paulvee/Lars-GPSDO-V4.2/IMG_3340.JPG

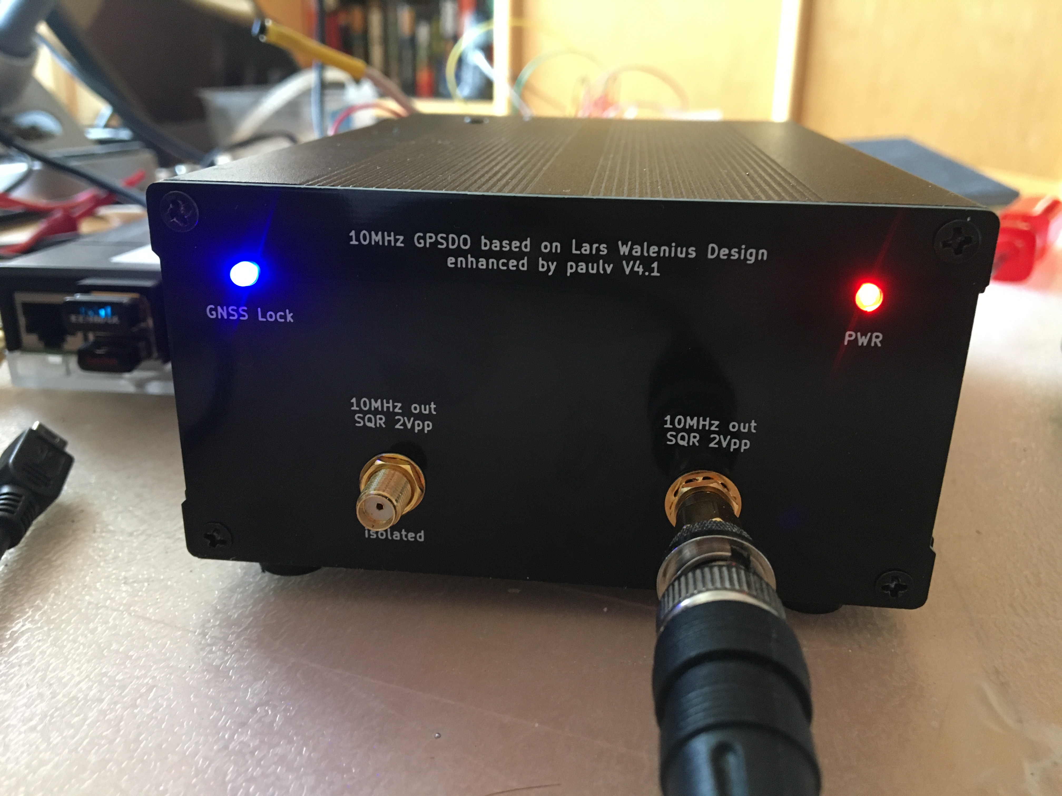
IMG_3340.JPG
