paulvee/Lars-GPSDO-V4.2/IMG_3341.JPG

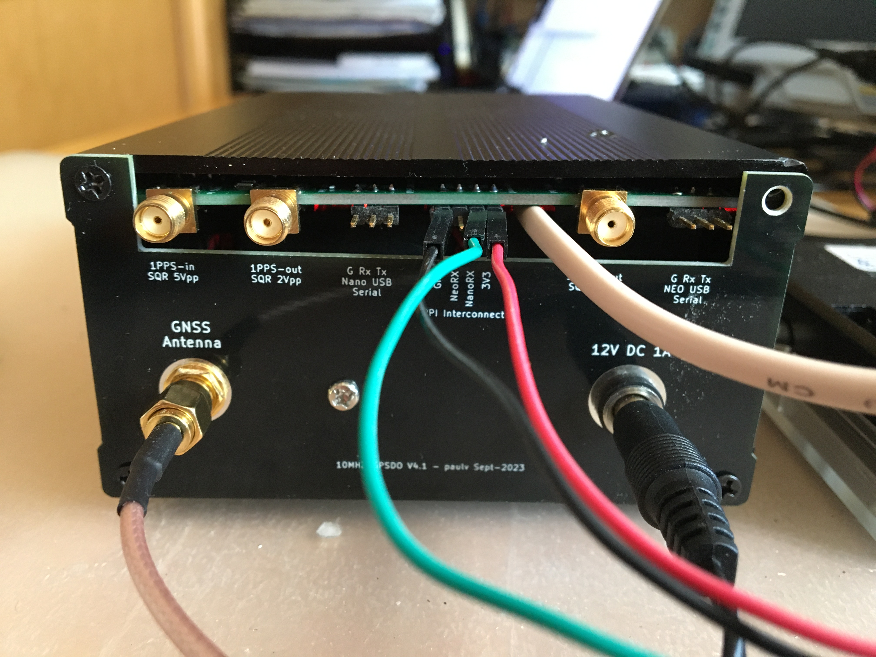
IMG_3341.JPG
