paulvee/Lars-GPSDO-V4.2/BackPlate.png

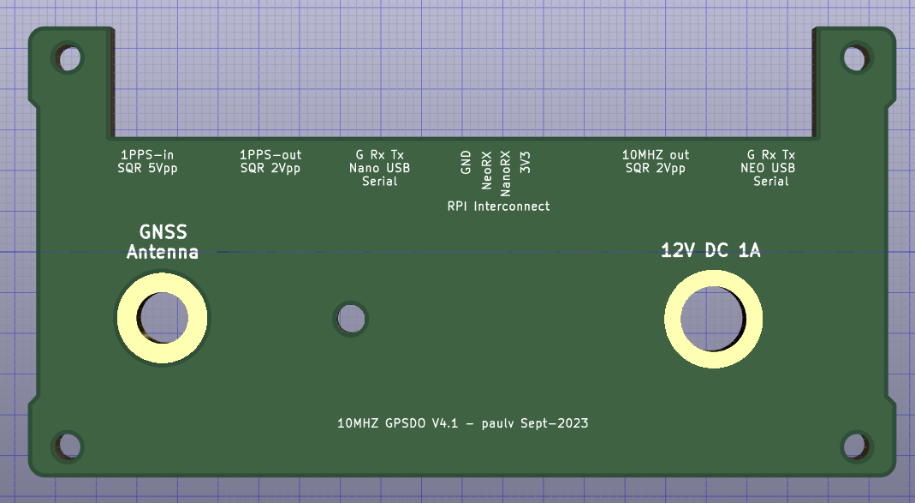
BackPlate.png
