paulvee/Lars-GPSDO-V4.2/Controller.png

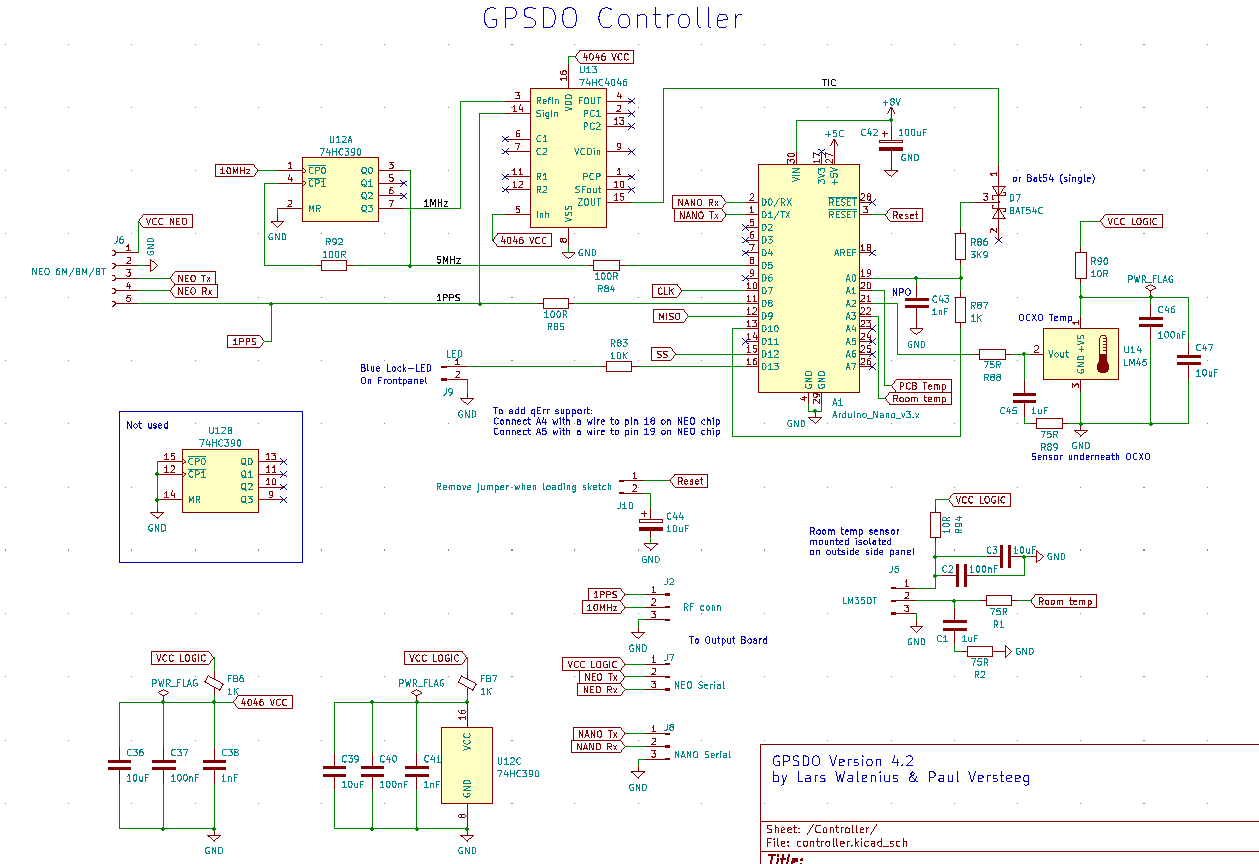
Controller.png
