paulvee/Lars-GPSDO-V4.2/DAC.png

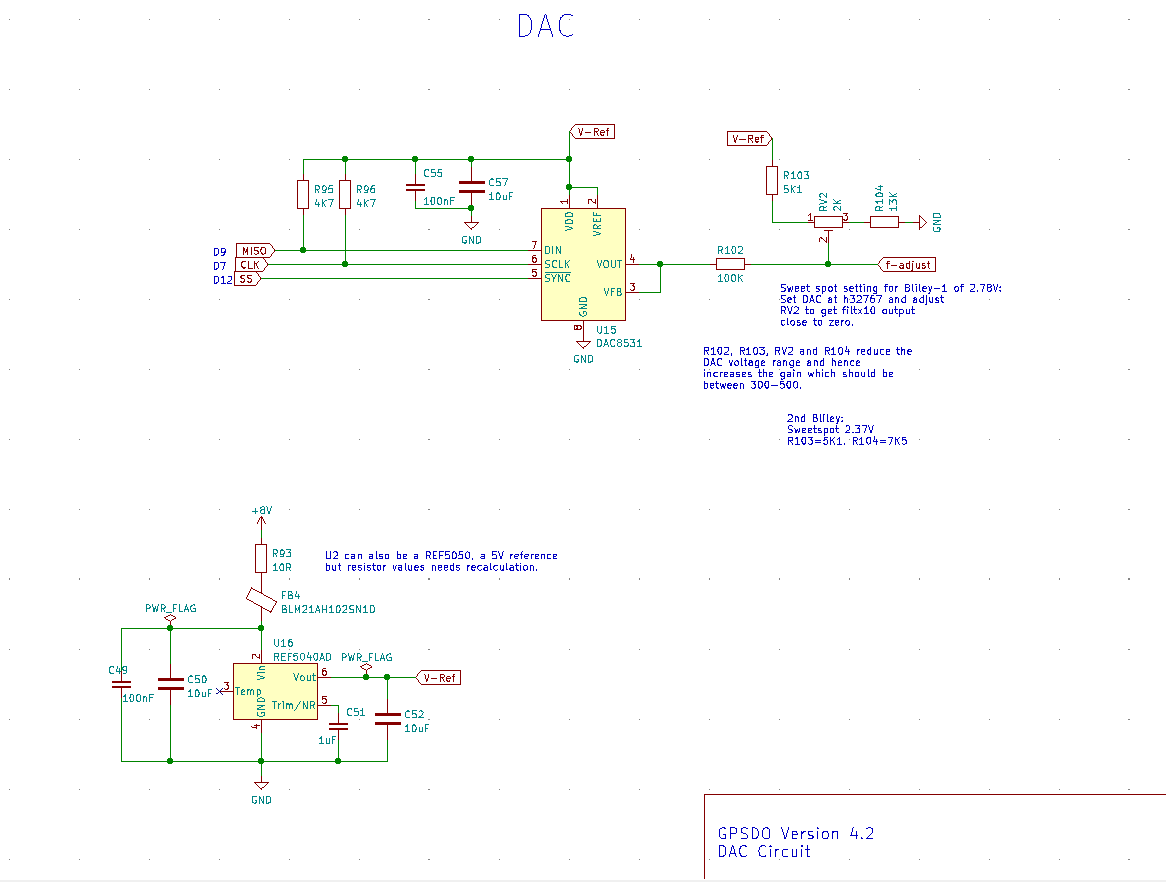
DAC.png
