paulvee/Lars-GPSDO-V4.2/FacePlate GPSDO.png

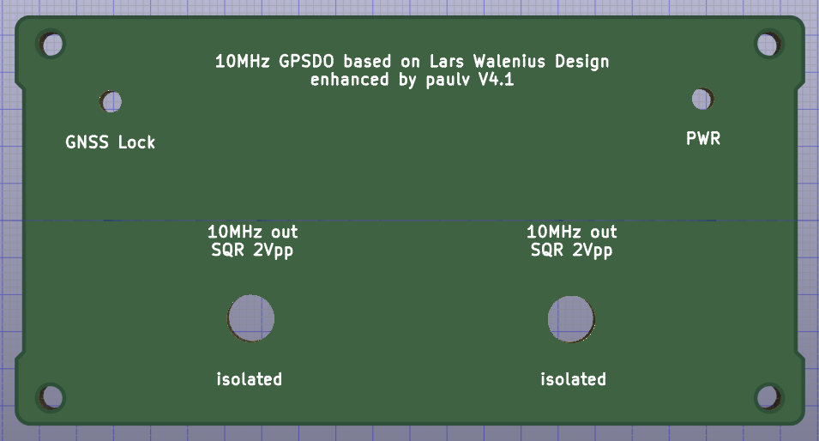
FacePlate GPSDO.png
