paulvee/Lars-GPSDO-V4.2/Heater.png

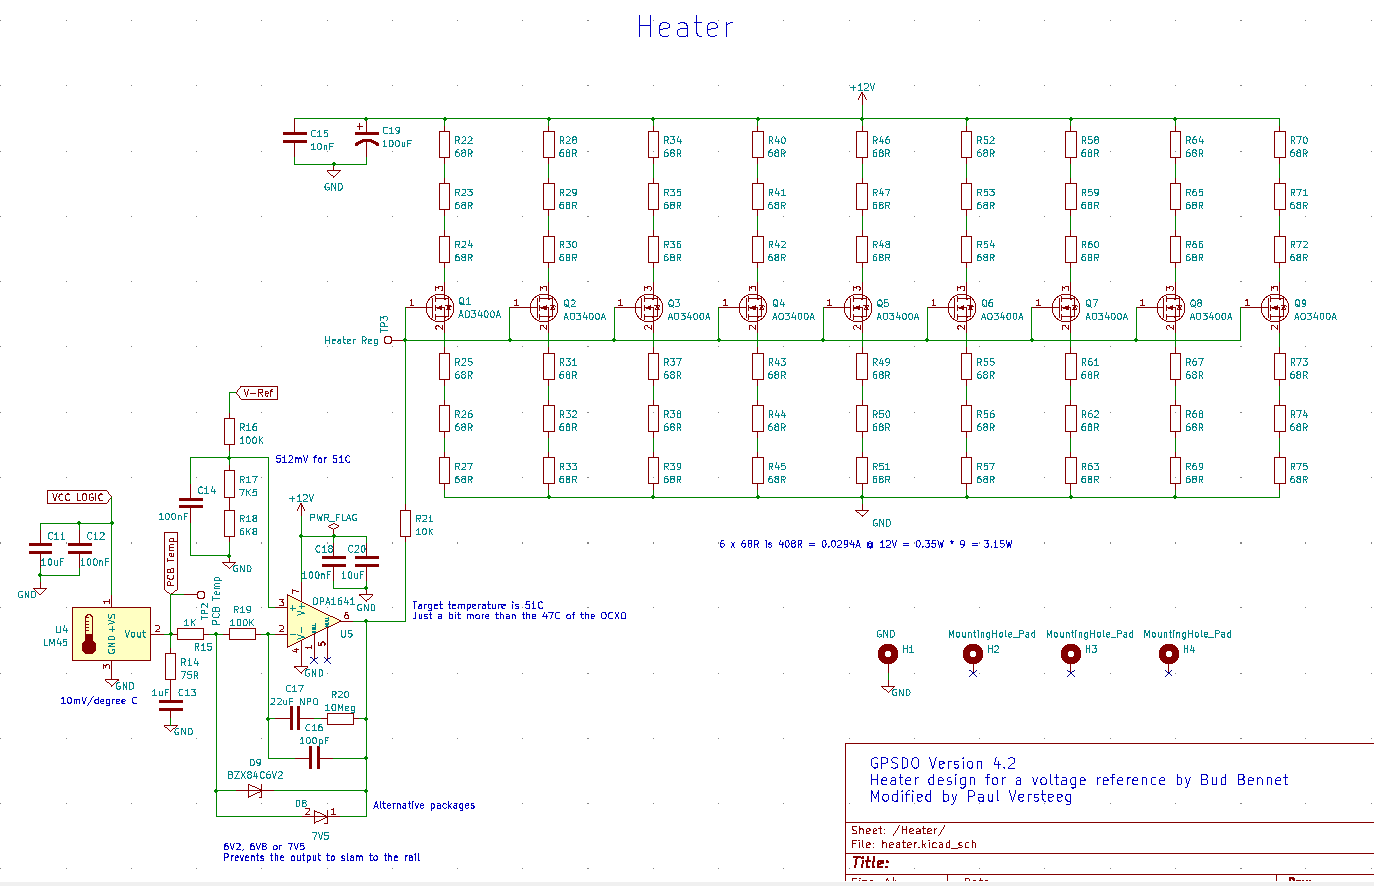
Heater.png
