paulvee/Lars-GPSDO-V4.2/IMG_3338.JPG

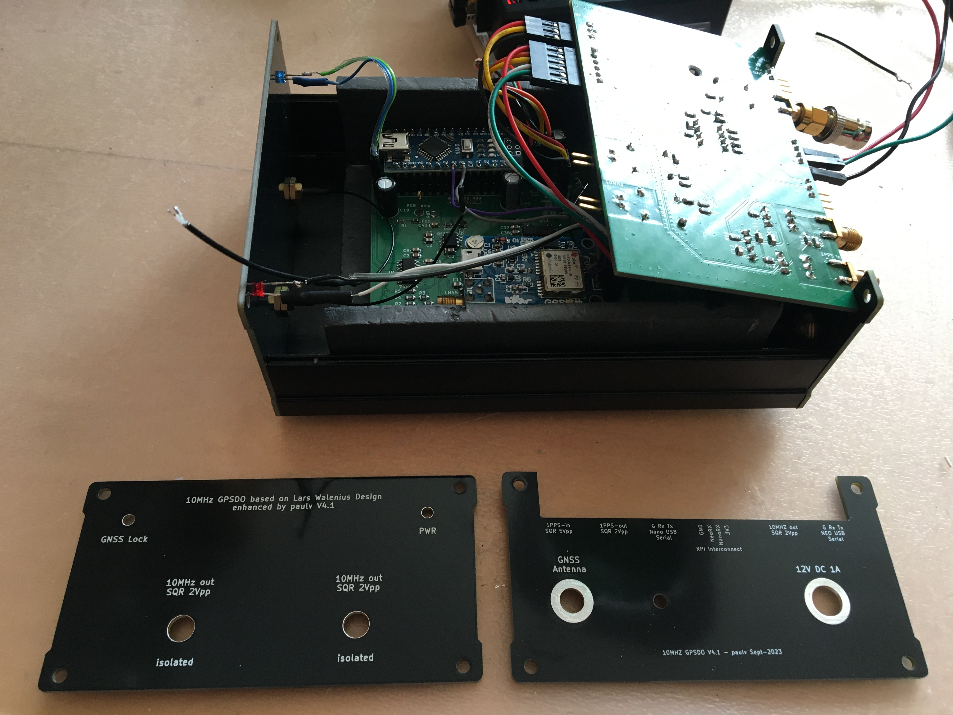
IMG_3338.JPG
