paulvee/Lars-GPSDO-V4.2/IMG_3339.JPG

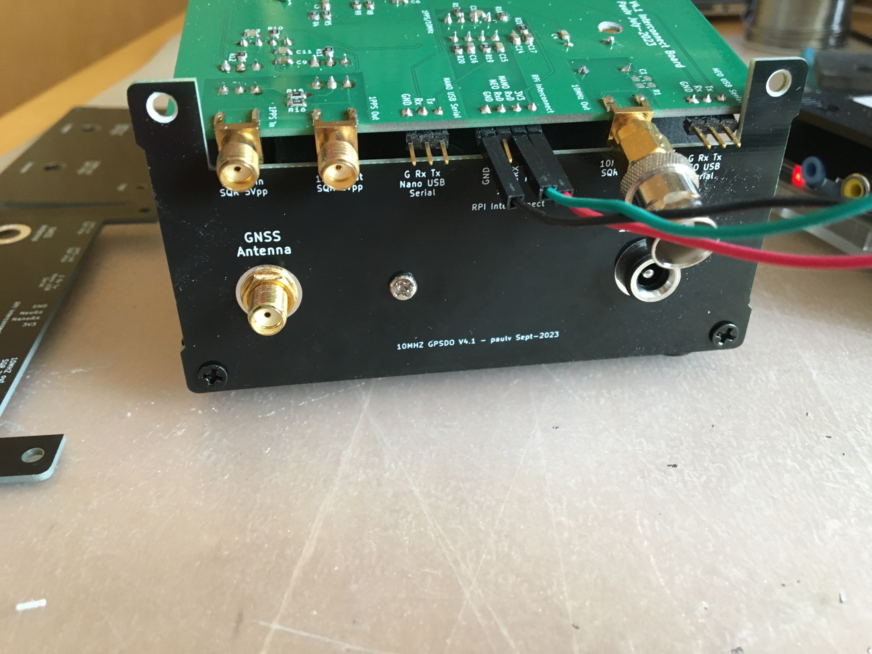
IMG_3339.JPG
