paulvee/Lars-GPSDO-V4.2/OCXO.png

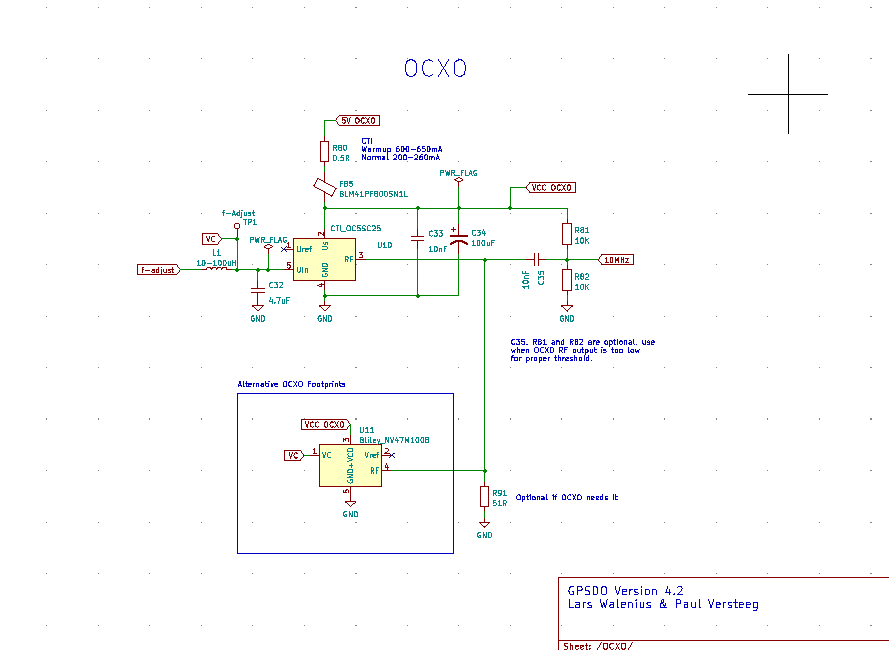
OCXO.png
