paulvee/Lars-GPSDO-V4.2/PCB-BOTTOM.png

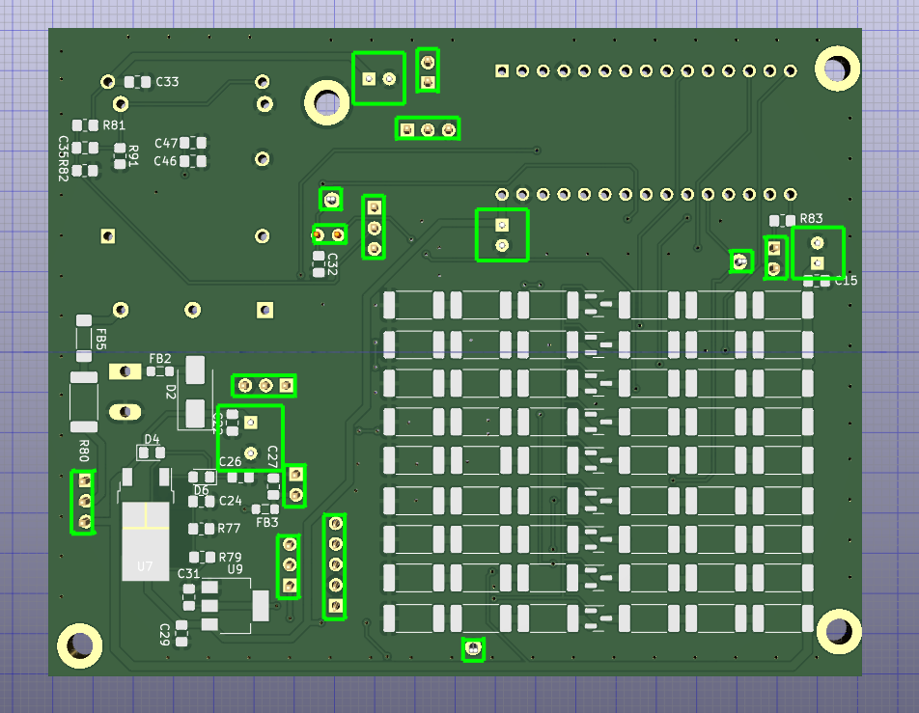
PCB-BOTTOM.png
