paulvee/Lars-GPSDO-V4.2/PCB-TOP.png

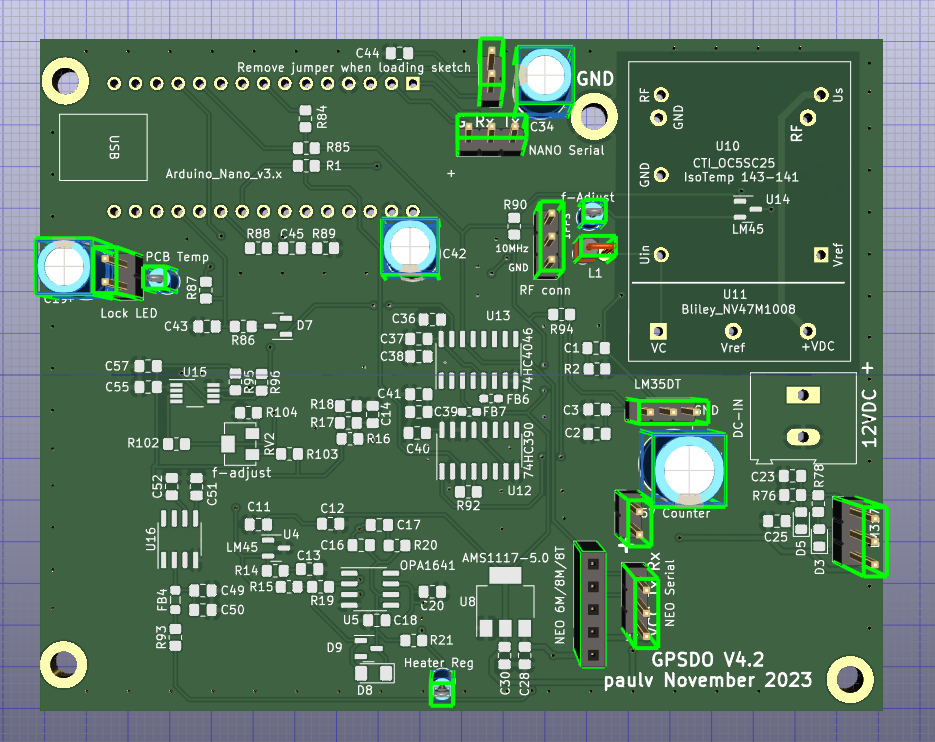
PCB-TOP.png
