paulvee/Lars-GPSDO-V4.2/Power.png

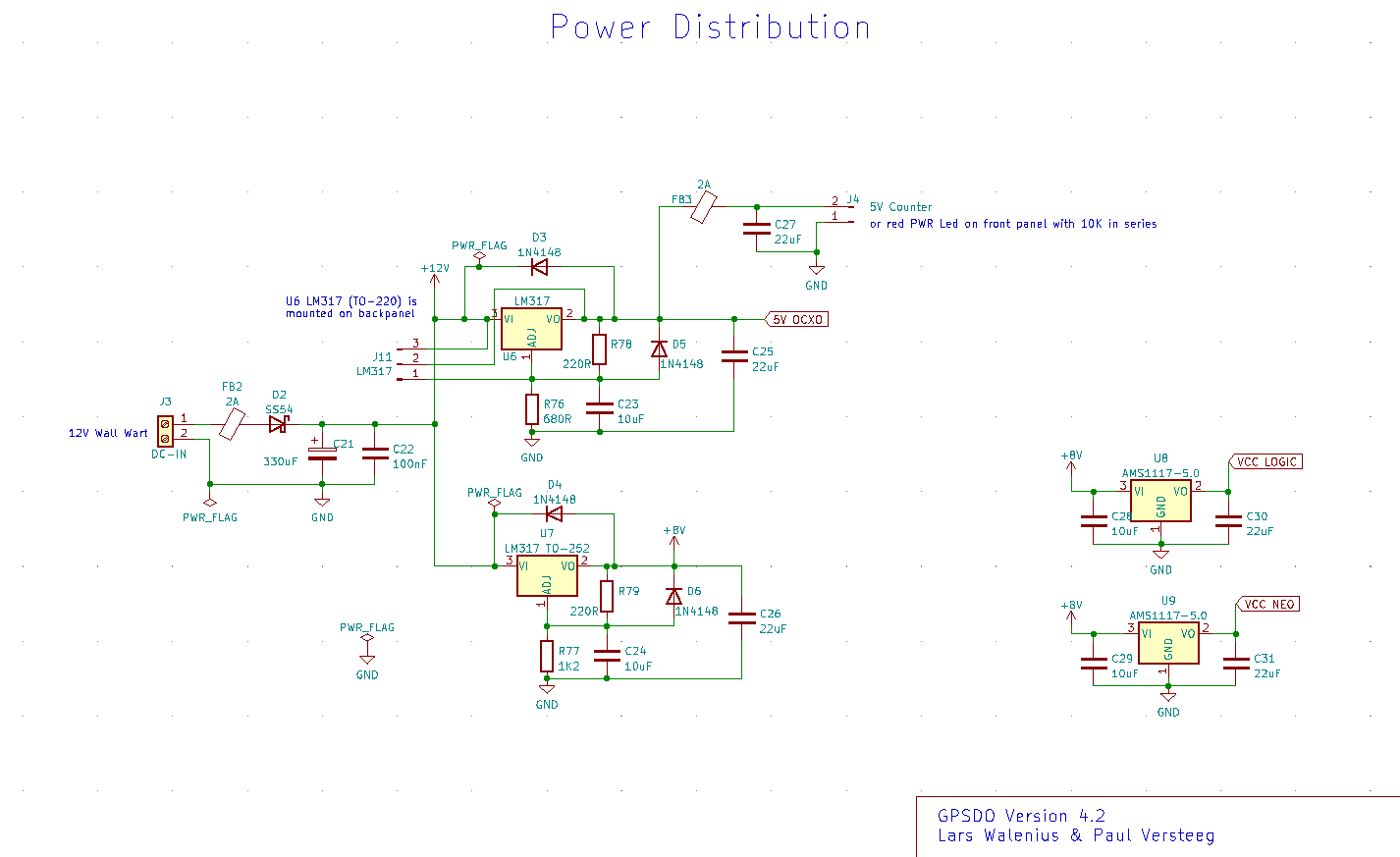
Power.png
