paulvee/Lars-GPSDO-V4.2/(threads)

Thread 1 (2024-10-20):

Missing GPSDO 4.2 Front panel

Pilgrim182551, 2024-10-20:
Missing GPSDO 4.2 Front panel Gerber files at PCBWAY. Uploaded twice back panel...

paulvee, 2024-10-21:
Sorry Pilgrim, but thanks for reporting. I fixed it.

Pilgrim182551, 2024-10-21:
Thank You Paul, appreciate Your work!

________________________________
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

Pilgrim182551, 2024-11-27:
Hi Paul, sorry to bother you, but the front panel you upladed to PCBWAY is not for GPSDOV4.2 but for 10Mhz Maser Clock...

davrad3, 2024-11-28:
Hi Paul,
i noticed the same thing.
Could you fix that?
I'm intrigued by your project
Thanks a lot !!

paulvee, 2024-11-28:
Hi guys, sorry for this mishap. I have just fixed it.
Thanks for pointing this out!
Paul

Thread 2 (2024-11-29):

Which Resistors R104, R103 needed for CTI OC5SC25

davrad3, 2024-11-29:
Hi Paul,
did you also check the CTI OCXO for its sweetspot? As far as i interpreted your schematic the values are for the Bliley only.
Thanks a lot in advance!!

paulvee, 2024-11-30:
@davrad3, have a look at earlier blogposts like the Version 3 and earlier for information/values for other OCXO's I used and tested.

Closed 2024-11-30.

Thread 3 (2024-12-12):

kicad files

zombu2, 2024-12-12:
is there any way we can get the kicad files so we can generate our own files like all csv and cpl files
the whole thing on pcbway is a lil confusing and seems to be missing parts of the post

thnx

paulvee, 2024-12-12:
Sorry but no. I never publish the source files.
One of the main reasons is to make it more difficult for others to commercially exploit my work.
Another one is that I want to be the master of the versioning to avoid a myriad of other revisions out there..
Many makers have been able to order the boards and build the system with the information I published.
If there is indeed something missing on the Blog or GitHub, let me know and I'll see what I can do.

zombu2, 2024-12-12:
i'm in need of the cpl file for the gpsdo 4.2 gerbers jlc asked for them and they also asked for the bom and cpl files for 4.1 output board since  they say they incorrect format and cannot be recognized by the system

thnx

paulvee, 2024-12-12:
Although I have very good experiences with JLPCB, I strongly suggest you order the boards through PCBWay, like all the others seem to do.

zombu2, 2024-12-12:
nah i been using jlc for years and i do not like pcbway at all ...personal preference really plus to be honest if you really want to know they way overpriced and i got tired of them sponsoring every video related or not to electronics

but that's not for here to discuss so if you would be so kind and consider sending me those files i would greatly appreciate it
and i rather send a donation to the author itself then using other means since they all skim off the top and the author gets less you did all the work why should they profit from it

zombu2, 2024-12-12:
hmmm aright seems i gotta make my own

paulvee, 2024-12-13:
OK, I spend some more time on this, just for those JLPCB users.
There is a special JLCPCB Zip file that was made with their "production" tool, and I also added the other files they want to the zip file. I tried the upload on their site and it works without complains.
Give it a try.

zombu2, 2024-12-13:
very nice thank you i send it off to them i suspect it be fine

thnx again

Closed 2024-12-12.

Thread 4 (2025-01-05):

more complete bom

zombu2, 2025-01-05:
bom is unusable for even finding some of the right parts it sometimes does not even say what the component is
jlcpcb has no idea what parts they are

any way to get the bom corrected and a description of the part what it actually is
fb6 1k does not mean much

i got the boards here and i'm really struggeling guessing what you used parts wise
lil help with the components would be appreciated i'm just a backyard tinkerer trying to build this thing
thnx

paulvee, 2025-01-05:
@zombu2
Dozens of people have been able to build this instrument.
It's not an IKEA project, and never intended to be manufactured by a board house.
Besides, I really don't like your tone, as if you paid for a product and it is not complete.
I provide everything for free for hobbyists that have a minimum amount of skill and know what they are doing.
If you don't have that skill, don't build it.

zombu2, 2025-01-05:
you don't like my tone? you know the tone is what you make of it there was no tone intended i think you just beeing this way because you don't like me for some reason maybe you think i'm a chinese cloner that tries to mass produce it

and just so we clear yes you provide it for free but you also have to look from the other side of the fence the builders here paid good money to have the boards made may it be from pcbway or jlcpcb and it is quiet a disappointment when you get the boards and can't finish it because the designer is beeing bitter and paranoid

you wanna hear a tone hear this loud and clear i will finish this and then i will post a full howto and if it takes me month i will reverse the gerbers thenn post everything fully open so the chinese can get cracking on it

is this the tone you wanted ? there it is  and don't bother deleting this i took a screenshot i will post of the whole thing if you do i want everyone to see how paranoid you are

paulvee, 2025-01-05:
zombu2, if you just cared to look earlier with more attention to the details and the data I provided, you could see that everything that is needed is there. If you care to read the README, you can see that I even made special data available for JLPCB users.

What was missing from your first post was a CAN YOU PLEASE HELP. You don't seem to understand how much time was already spend providing the information that is already there, and apparently sufficient for many others. I do this totally for free, as a hobby.

zombu2, 2025-01-06:
oh i read it aright but you leave out just enough info so one has to guess
oh have i not paid enough attention to you would you like me to send you an email every day thank you so much for this project

in fact your paranoia completely ruins the whole thing i though this was a pretty cool project to build but it is ruined by you
and only you and your crappy attitude  and just so you know i don't need to be talked down to from some dude on the internet who thinks he is the second coming of jesus because he made gpsdo

you set the tone here and only you i'm sorry you bitter and miserable but there is no need to rub it in ppl's faces every chance you get that you made this in your free time bla bla bla
we get and we know if you feel you not getting enough attention simply take it down instead of making everyone around you as miserable as yourself

i for one will finish this with or without you since i already have time and money invested in this and i will post a complete bom and maybe the reversed kicad files just to piss you off and i sure hope the chinese will take it and make a million of them

and when they do remember that all this was caused by  your crappy attitude and the need for validation

toodles

Closed 2025-01-05.
